e1aco/EP-002-Buck/Hardware/5V输出.jpg

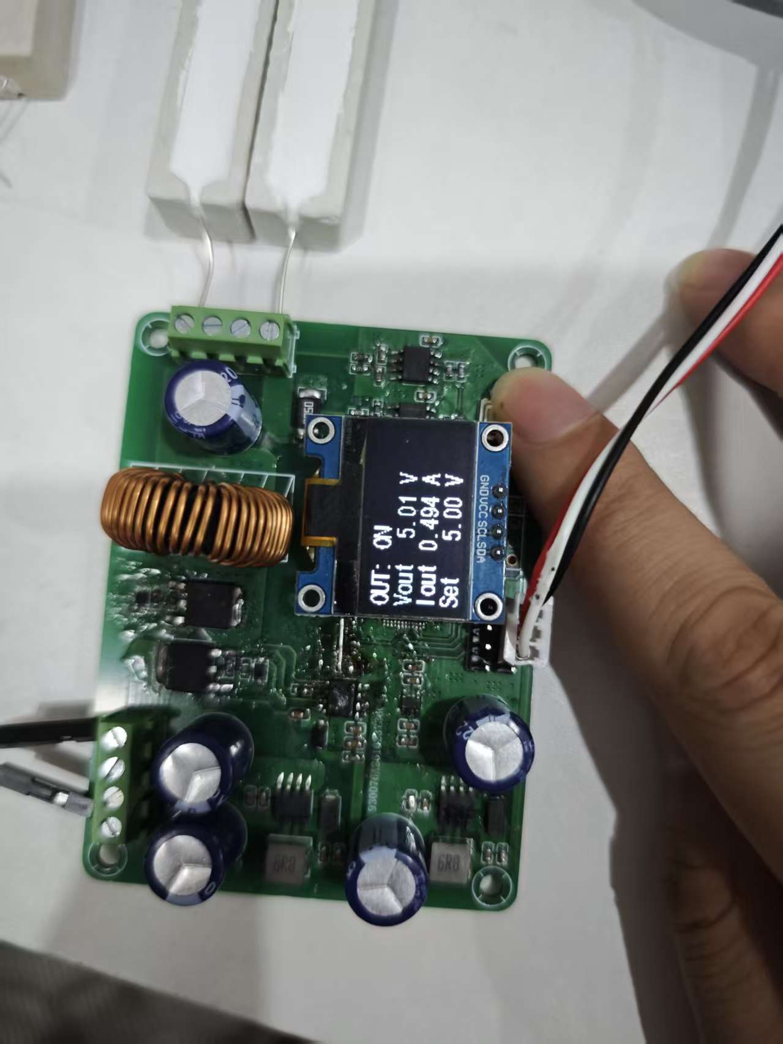
Hardware/5V输出.jpg
