e1aco/EP-002-Buck/Hardware/关闭输出.jpg

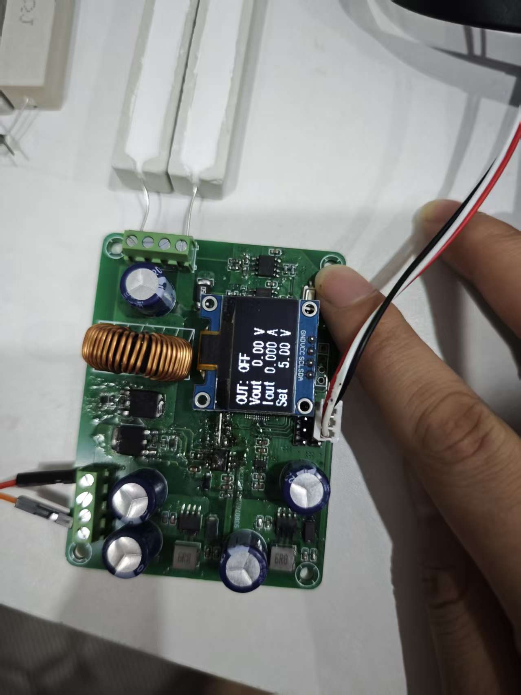
Hardware/关闭输出.jpg
