e1aco/EP-002-Buck/Firmware/Buck/datasheet/电感参数.jpg

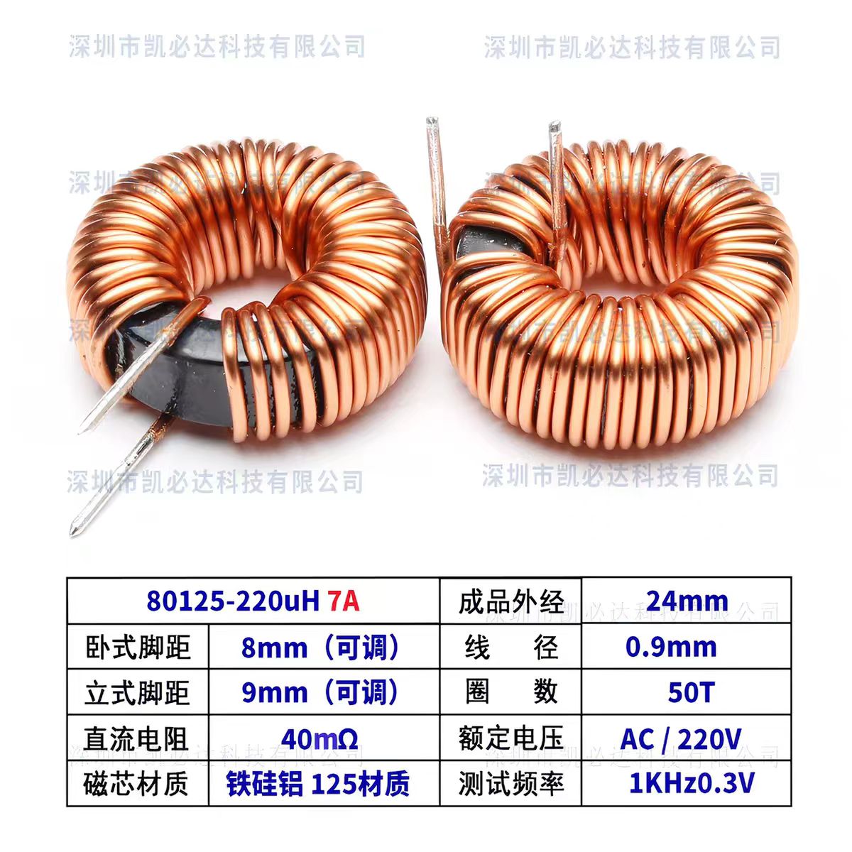
Firmware/Buck/datasheet/电感参数.jpg
