e1aco/EP-002-Buck/Hardware/12V输出.jpg

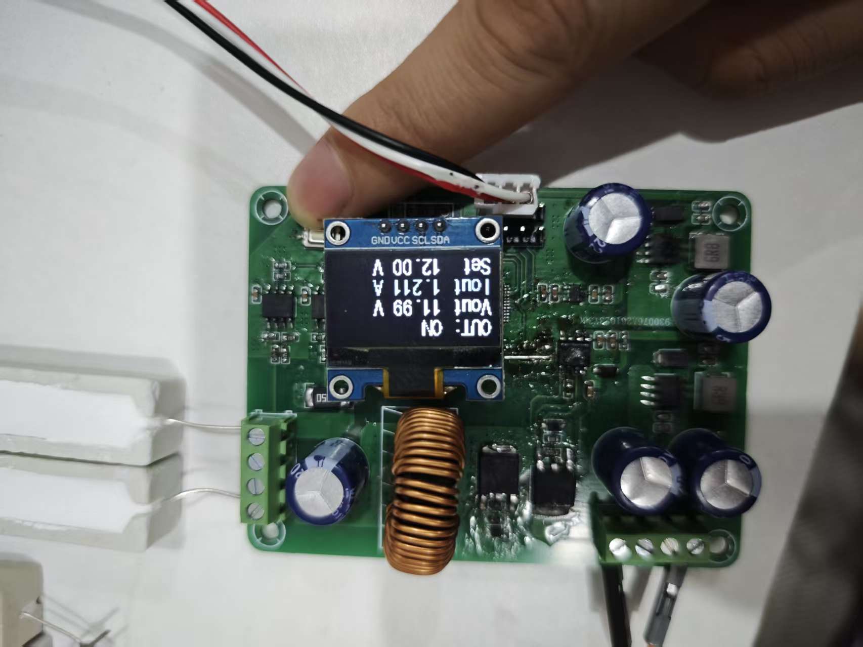
Hardware/12V输出.jpg
