e1aco/EP-002-Buck/Hardware/SCH_Buck_1-Buck_2026-10-24.png

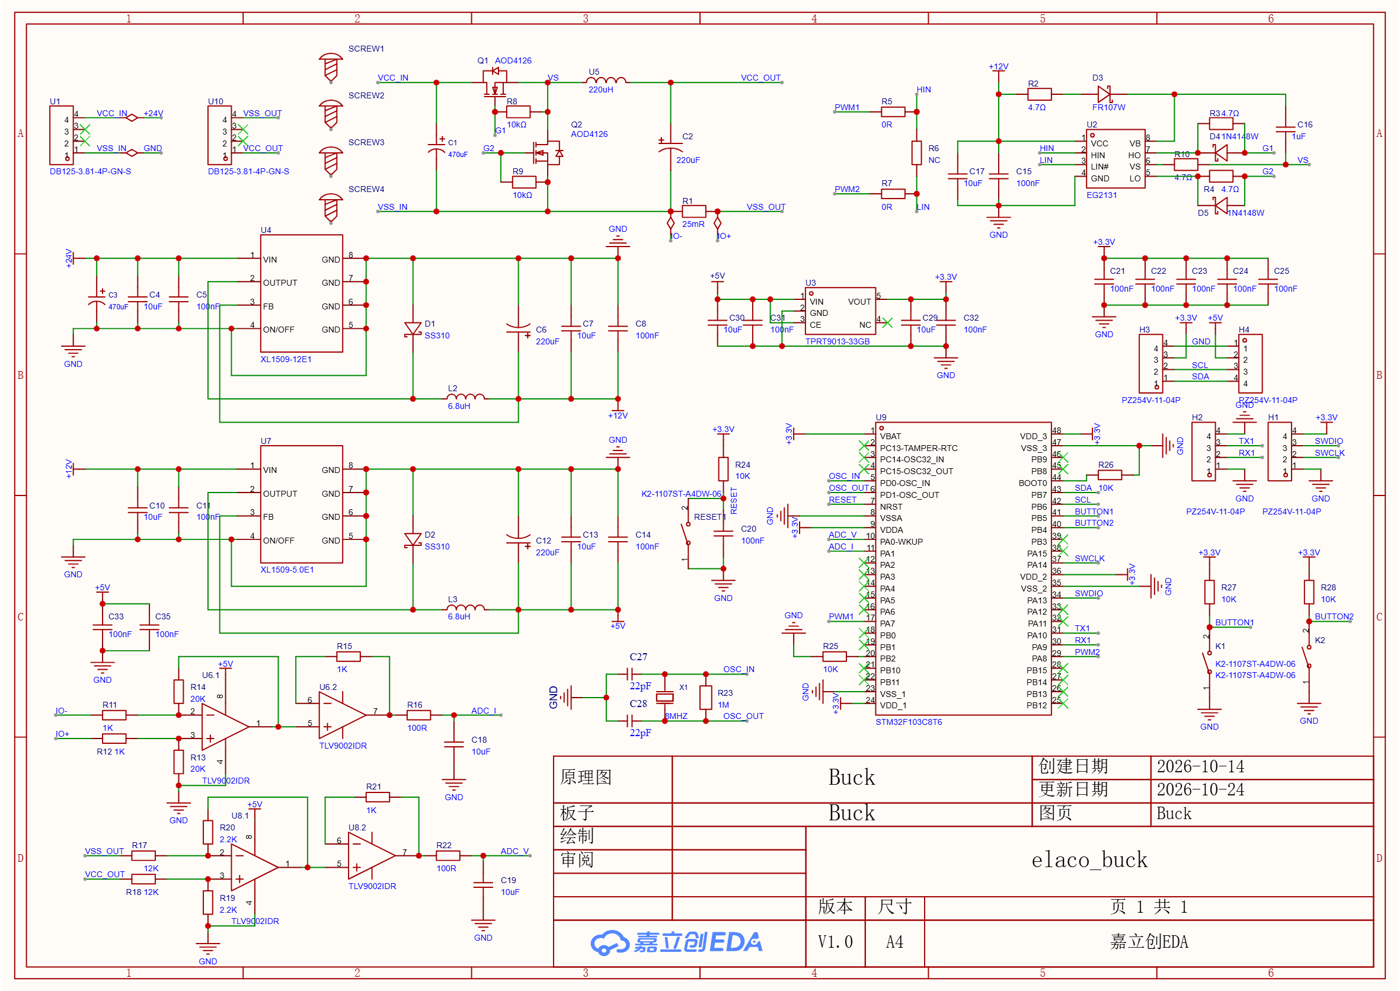
Hardware/SCH_Buck_1-Buck_2026-10-24.png
