e1aco/EP-002-Buck/Hardware/tune_waveform.png

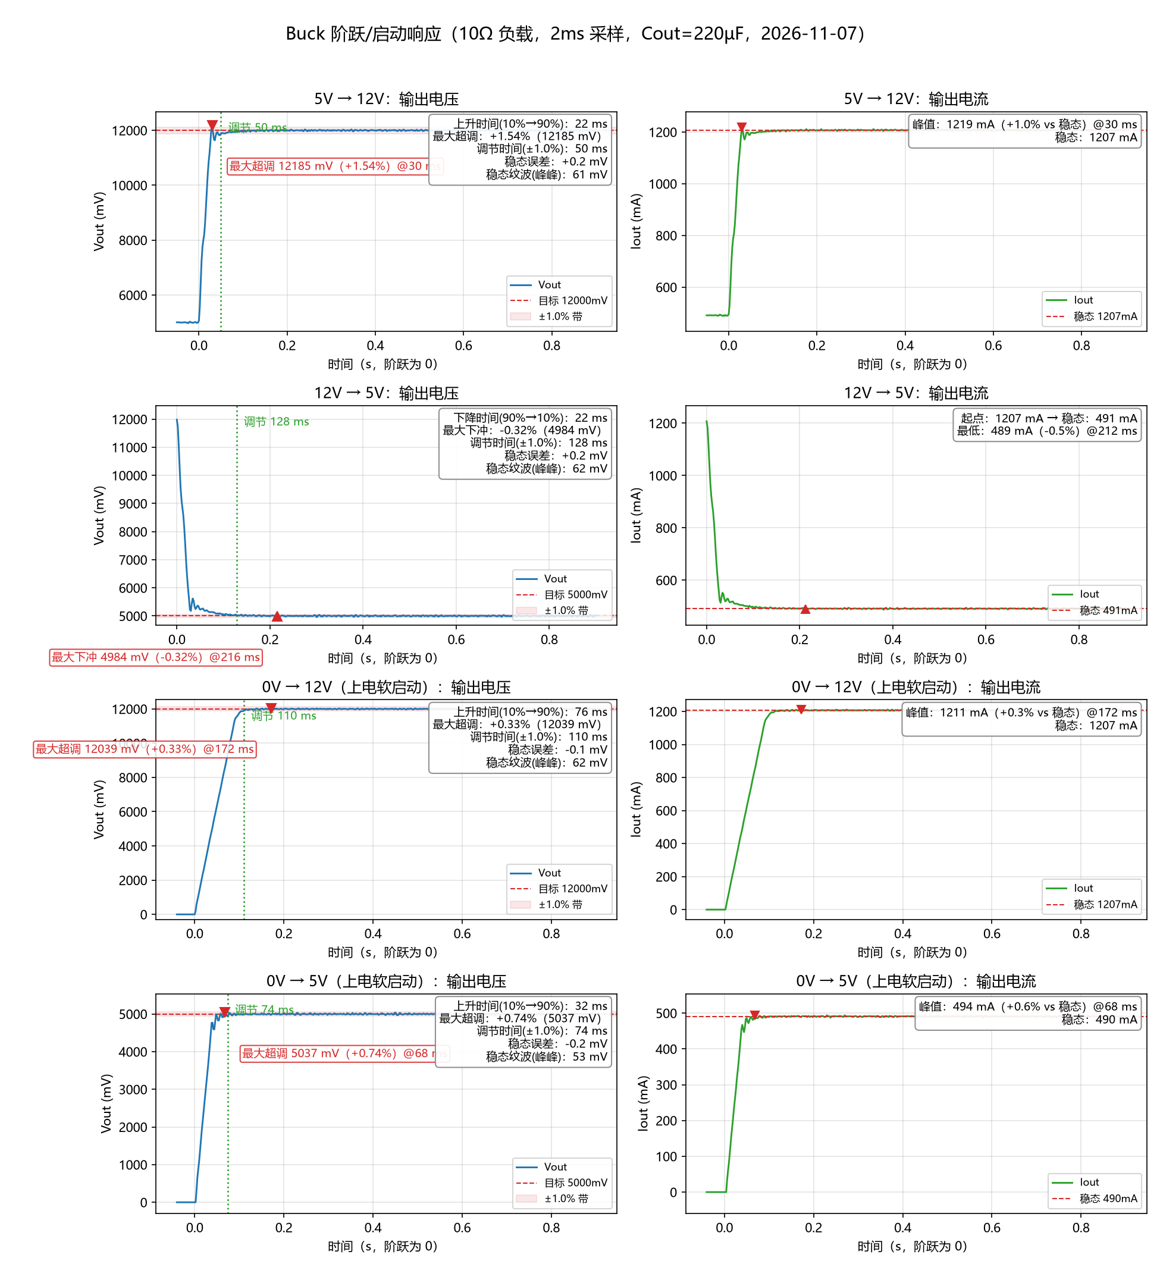
Hardware/tune_waveform.png
