e1aco/EP-002-Buck/Firmware/Buck/Core/Src/main.c

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
/* Includes ------------------------------------------------------------------*/
#include "main.h"
#include "adc.h"
#include "dma.h"
#include "i2c.h"
#include "tim.h"
#include "usart.h"
#include "gpio.h"

/* USER CODE BEGIN Includes */
#include "bsp_pwm.h"
#include "drv_pwm.h"
#include "app_control.h"
#include "app_key.h"
#include "app_telemetry.h"
#include "app_display.h"
#include "config.h"
#include "tim_test.h"
#include "tim_adc_calib.h"
#include "pwm_sweep.h"
#include "adc_cal_sweep.h"
#include "tune_log.h"
/* USER CODE END Includes */


void SystemClock_Config(void);
/**
  * @brief  The application entry point.
  * @retval int
  */
int main(void)
{

  /* MCU Configuration--------------------------------------------------------*/

  /* Reset of all peripherals, Initializes the Flash interface and the Systick. */
  HAL_Init();

  /* Configure the system clock */
  SystemClock_Config();

  /* Initialize all configured peripherals */
  MX_GPIO_Init();
  MX_DMA_Init();
  MX_TIM1_Init();
  MX_ADC1_Init();
  MX_TIM4_Init();
  MX_USART1_UART_Init();
  MX_I2C1_Init();
  /* USER CODE BEGIN 2 */
  BSP_PWM_InitPins(); // 配置PA7为TIM3驱动的PWM
  DRV_PWM_Init(); // PWM初始化
#if (CL_CTRL_ENABLE == 1)
  APP_CONTROL_Init();   // 闭环接管 CCR1（须在 ADC 启动前，避免 ISR 用到未初始化的 PID）
#else
  DRV_PWM_SetDutyCount(DRV_PWM_DUTY_CNT_50PCT); // 开环
#endif
  APP_TELEMETRY_Init();           // 1Hz 遥测打印
  APP_KEY_Init();                 /* 按键消抖初值（Key1 开关机、Key2 切 5V/12V） */
  APP_DISPLAY_Init();             /* 0.96" OLED：OUT 状态 / Vout / Iout / Set（I2C1） */
  // TEST_TIM_Init();             // 时序探针        [CL_TIMING_MEASURE]
  // TIM_ADC_CALIB_Run();         // ADC 转换时间标定 [CL_ADC_CALIB]
  // PWM_SWEEP_Init();            // 开环扫档        [CL_PWM_SWEEP]
  // ADC_CAL_SWEEP_Init();        // ADC 标定单点保持 [CL_ADC_CAL_SWEEP]
#if CL_TUNE_LOG
  TUNE_LOG_Init();             /* 调参采样 [CL_TUNE_LOG] */
#endif
  /* USER CODE END 2 */

  /* Infinite loop */
  /* USER CODE BEGIN WHILE */
  while (1)
  {
    /* USER CODE END WHILE */

    /* USER CODE BEGIN 3 */
    APP_TELEMETRY_Loop();
    APP_CONTROL_Loop();     // ADC 采样停更超时 → 停波
    APP_KEY_Loop();         /* 按键消抖 + 按下沿事件 */
    APP_DISPLAY_Loop();     /* OLED 10Hz 局部刷新（400kHz 下单次 ≤~12ms） */
    // PWM_SWEEP_Loop();       // [CL_PWM_SWEEP]
    // ADC_CAL_SWEEP_Loop();   // [CL_ADC_CAL_SWEEP]
    DRV_PWM_Loop();         // 内脉冲补写
#if CL_TUNE_LOG
    TUNE_LOG_Loop();     /* 调参采样 50ms [CL_TUNE_LOG] */
#endif
  }
  /* USER CODE END 3 */
}

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
