e1aco/EP-002-Buck/Firmware/Buck/Buck.ioc

Mcu.UserName=STM32F103C8Tx
PA0-WKUP.Signal=ADCx_IN0
PA1.Signal=ADCx_IN1
PA10.Signal=USART1_RX
PA13.Signal=SYS_JTMS-SWDIO
PA14.Signal=SYS_JTCK-SWCLK
PA8.Signal=S_TIM1_CH1
PA9.Signal=USART1_TX
PB4.GPIO_Label=Key2
PB4.Signal=GPIO_Input
PB5.GPIO_Label=Key1
PB5.Signal=GPIO_Input
PB6.Signal=I2C1_SCL
PB7.Signal=I2C1_SDA
PB9.Signal=S_TIM4_CH4
PD0-OSC_IN.Signal=RCC_OSC_IN
PD1-OSC_OUT.Signal=RCC_OSC_OUT
