e1aco/EP-002-Buck/Firmware/Buck/Core/Inc/main.h

#define Key2_Pin GPIO_PIN_4
#define Key2_GPIO_Port GPIOB
#define Key1_Pin GPIO_PIN_5
#define Key1_GPIO_Port GPIOB
