e1aco/EP-002-Buck/Firmware/Buck/module/drv/drv_oled_font.c

/*****************************************************************************
 * @文件: drv_oled_font.c
 * @作者: cl
 * @日期: 2026-11-08
 * @版本: v1.0
 * @说明: SSD1306 8x16 ASCII 点阵字库（0x20-0x7E），行字节 LSB=最左像素
 * @依赖: 无
 ****************************************************************************/
#include "drv_oled_font.h"

/* ==== 字库数据 ==== */

const uint8_t DRV_OLED_FONT8X16[DRV_OLED_FONT_COUNT][DRV_OLED_FONT_H] = {
    /* 0x20 ' ' */
    {0x00, 0x00, 0x00, 0x00, 0x00, 0x00, 0x00, 0x00,
     0x00, 0x00, 0x00, 0x00, 0x00, 0x00, 0x00, 0x00},
    /* 0x21 '!' */
    {0x00, 0x00, 0x0C, 0x0C, 0x0C, 0x0C, 0x0C, 0x0C,
     0x08, 0x08, 0x08, 0x08, 0x00, 0x0C, 0x00, 0x00},
    /* 0x22 '"' */
    {0x00, 0x00, 0x34, 0x34, 0x34, 0x24, 0x00, 0x00,
     0x00, 0x00, 0x00, 0x00, 0x00, 0x00, 0x00, 0x00},
    /* 0x23 '#' */
    {0x00, 0x00, 0x48, 0x4C, 0x6C, 0x64, 0xFF, 0x24,
     0x24, 0x26, 0xFF, 0x32, 0x12, 0x12, 0x00, 0x00},
    /* 0x24 '$' */
    {0x00, 0x18, 0x3C, 0x7E, 0x4A, 0x1A, 0x12, 0x1C,
     0x78, 0x48, 0x48, 0x4A, 0x7E, 0x3C, 0x18, 0x00},
    /* 0x25 '%' */
    {0x00, 0x00, 0x26, 0x26, 0x21, 0x11, 0x16, 0x16,
     0x68, 0xA8, 0xA8, 0xA0, 0xA4, 0x64, 0x00, 0x00},
    /* 0x26 '&' */
    {0x00, 0x00, 0x1C, 0x14, 0x36, 0x34, 0x14, 0x0C,
     0x0E, 0x72, 0x73, 0x23, 0x72, 0x5C, 0x00, 0x00},
    /* 0x27 'quote' */
    {0x00, 0x00, 0x08, 0x08, 0x08, 0x08, 0x00, 0x00,
     0x00, 0x00, 0x00, 0x00, 0x00, 0x00, 0x00, 0x00},
    /* 0x28 '(' */
    {0x00, 0x00, 0x30, 0x10, 0x18, 0x08, 0x0C, 0x0C,
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
     0xC2, 0xC3, 0xC2, 0xC2, 0xE6, 0xFC, 0xC0, 0x46},
    /* 0x68 'h' */
    {0x00, 0x00, 0x03, 0x03, 0x03, 0x3F, 0x63, 0x63,
     0x63, 0x63, 0x63, 0x63, 0x63, 0x63, 0x00, 0x00},
    /* 0x69 'i' */
    {0x00, 0x00, 0x18, 0x00, 0x00, 0x18, 0x18, 0x18,
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
};
