e1aco/EP-002-Buck/Firmware/Buck/module/app/app_key.h

/*****************************************************************************
 * @文件: app_key.h
 * @作者: cl
 * @日期: 2026-11-06
 * @版本: v1.0
 * @说明: 按键应用（20ms 消抖 + 按下沿事件分发：Key1 开关机、Key2 切 5V/12V）
 * @平台: STM32F103C8T6
 * @依赖: bsp_key（引脚/极性）、app_control（输出开关、档位切换）
 ****************************************************************************/
#ifndef __APP_KEY_H
#define __APP_KEY_H

/**
 * @说明: 初始化按键状态（以当前电平为稳定初值，避免上电误触发）
 * @注意: 在 APP_CONTROL_Init 之后调用
 */
void APP_KEY_Init(void);

/**
 * @说明: 主循环调用——消抖、按下沿分发事件
 * @注意: 主循环周期需远小于消抖时间（当前 while 循环 ~µs 级，满足）
 */
void APP_KEY_Loop(void);

#endif /* __APP_KEY_H */
