e1aco/EP-002-Buck/Firmware/Buck/module/bsp/bsp_pwm.h

/*****************************************************************************
 * @文件: bsp_pwm.h
 * @作者: cl
 * @日期: 2026-10-30
 * @版本: v1.0
 * @说明: 互补 PWM 板级资源接口（PA8=TIM1_CH1 → LIN#，PA7=TIM1_CH1N → 外部反相 → HIN）
 * @平台: STM32F103C8T6
 ****************************************************************************/
#ifndef __BSP_PWM_H
#define __BSP_PWM_H

/**
 * @说明: 配 TIM1 部分重映射（CH1N 落 PA7）+ PA7 复用推挽输出
 * @注意: 必须在 MX_TIM1_Init 之后、DRV_PWM_Init 之前调用
 */
void BSP_PWM_InitPins(void);

#endif /* __BSP_PWM_H */
